pivnakeduardovich/SPEKS.SLS/README.md

<div align="center">

# СПЕКС

### Компактный SLS-принтер с альтернативной системой подачи порошка

</div>

---

## О проекте

**СПЕКС** — это доступный принтер селективного лазерного спекания (SLS) для мелкосерийного производства и изготовления оснастки. Главная идея проекта в **удешевлённой подаче порошка**: вместо дорогого второго поршня или барабана порошок засыпается в бункер сверху и разравнивается гребёнкой на каретке.

## Ключевые характеристики

| Параметр | Значение |
|---|---|
| Область печати | 150 × 150 × 150 мм |
| Кинематика XY | H-bot на валах Ø10 мм, подшипники LM10UU с уплотнителями |
| Ось Z | подъёмный столик, без ходовых винтов в зоне печати |
| Лазер | CO₂-трубка сбоку, луч идёт через систему зеркал |
| Подача порошка | бункер сверху + гребёнка на каретке, съёмная коробка объёмом ×1,5 от зоны печати |
| Камера | герметичная, с подогревом, моторы вынесены за изоляцию |
| Корпус | обшивка из стеклотекстолита, теплоизоляция |
| Моторы | NEMA 17 (X, Y, гребёнка, подача), NEMA 23 (Z, высота гребёнки) |
| Электроника | BTT Octopus Pro + Klipper |

## Как это работает

```
   ┌──────────── бункер с порошком ────────────┐
   │                    ▼                      │
   │   гребёнка на каретке разравнивает слой   │
   │                    ▼                      │
   │   CO₂-лазер → зеркала → спекание слоя     │
   │                    ▼                      │
   │   стол опускается на толщину слоя (Z)     │
   └──────────────── повтор ───────────────────┘
```

## Структура репозитория

| Папка | Что внутри |
|---|---|
| [`A3D/`](A3D) | сборки КОМПАС-3D. Актуальная сборка принтера: «Арт СБОРКА (пересборка)». Узлы: «Бункер подачи» (короб с поршнем, винтом и мотором), «Каркас» и «Профиль стола 2» (рама из профиля 20×20). Прежние версии: «Внутренняя коробка», «Коробка 2.0» |
| [`M3D/`](M3D) | детали. Листовые из алюминия 3 мм: «Бункер настольный 2.0» и детали бункера подачи (плита опорная, короб, крышка, поршень, кронштейн мотора, уголок). Остальное: рама стола, каретки, направляющие, винты, лазерная трубка |
| [`STEP/`](STEP) | STEP-модели покупных и собственных деталей (профиль 20×20, подшипники, моторы, зеркала) |
| [`SLS stp for IA/`](SLS%20stp%20for%20IA) | исходная рабочая сборка. В [`АртSLS/`](SLS%20stp%20for%20IA/АртSLS) лежат детали и подсборки актуальной версии: портал XY, гребёнка, ремни, оптика, моторы |
| [`kicad/`](kicad) | электрическая схема в KiCad (проект `speks.kicad_pro`, 3 листа) и её PDF |
| [`Мои профили/`](Мои%20профили) | библиотека профилей КОМПАС |

> Файлы `.a3d` и `.m3d` открываются в **КОМПАС-3D**, `.stp` / `.STEP` — в любом CAD (Fusion 360, FreeCAD, SolidWorks).

## Дорожная карта

- [x] Выбор кинематики (H-bot) и схемы подачи порошка
- [x] 3D-модель рамы, портала XY и оси Z
- [x] Компоновка лазера и зеркал
- [ ] Выбор модели CO₂-трубки
- [ ] Корпус и термоизоляция камеры
- [x] Принципиальная электрическая схема (KiCad)
- [ ] Электроника и конфиг Klipper
- [ ] Собственный слайсер
- [ ] Сборка прототипа и тестовая печать

---

<div align="center">
<sub>Автор: Piv · Научный руководитель: Алёна Павловна</sub>
</div>
