pivnakeduardovich/SPEKS.SLS/docs/images/obshiy_vid.png

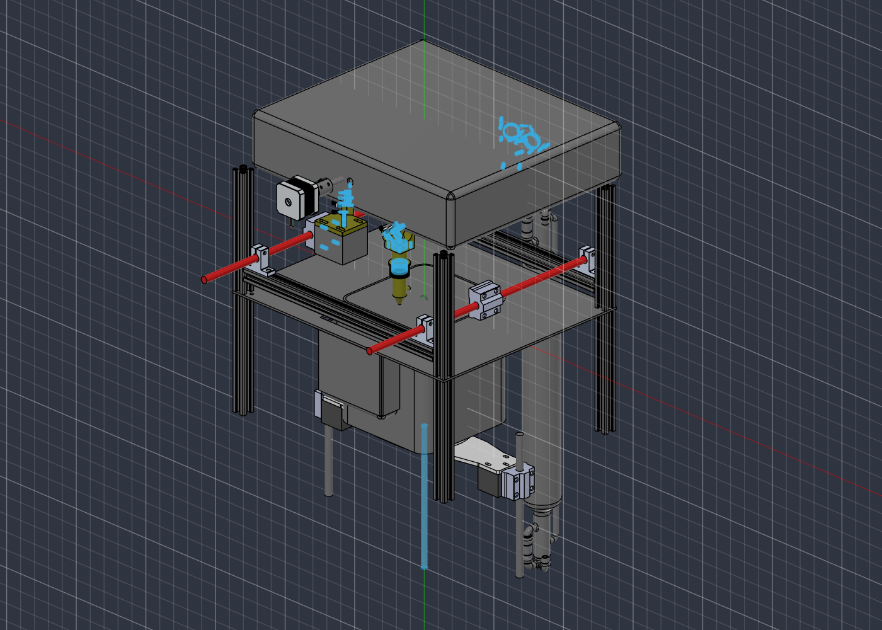
docs/images/obshiy_vid.png
