pivnakeduardovich/SPEKS.SLS/docs/images/vid_speredi.png

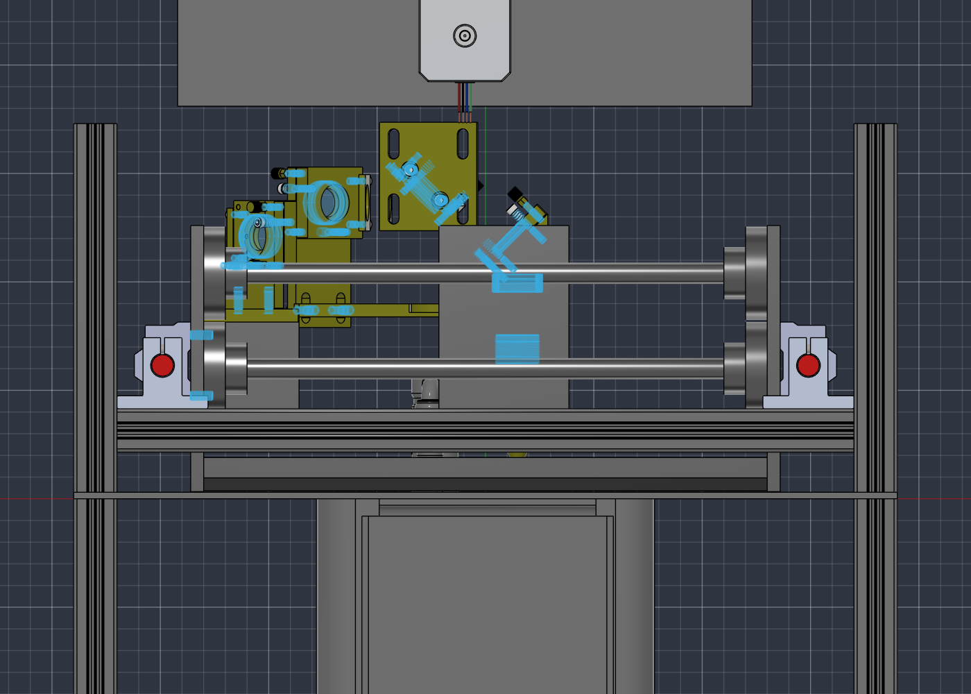
docs/images/vid_speredi.png
