pivnakeduardovich/SPEKS.SLS/docs/images/xy_portal.png

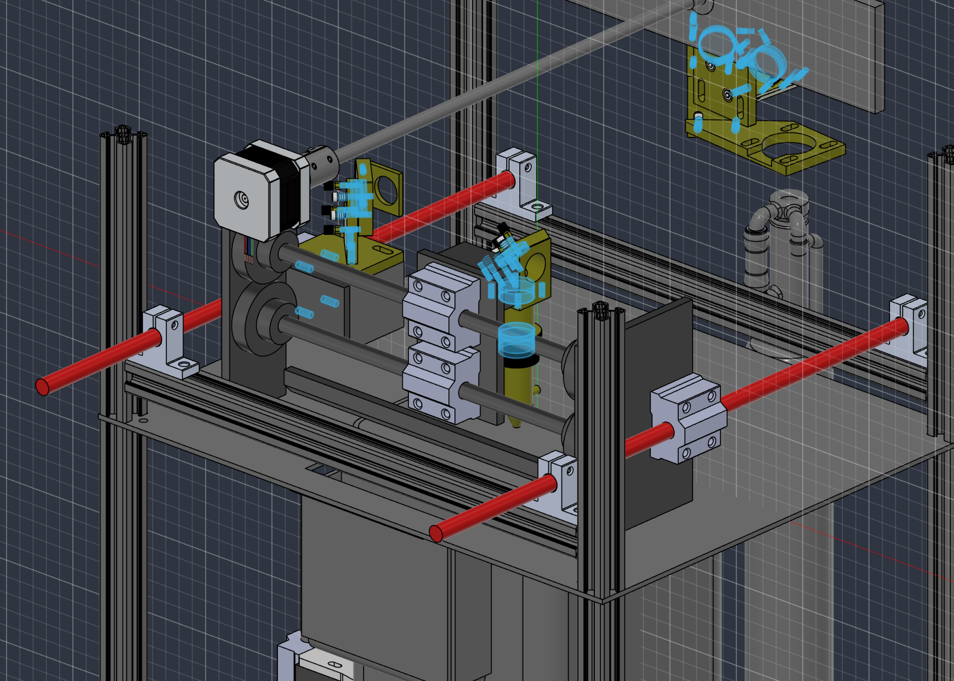
docs/images/xy_portal.png
