pivnakeduardovich/SPEKS.SLS/SLS stp for IA/АртSLS/CoreXY.png

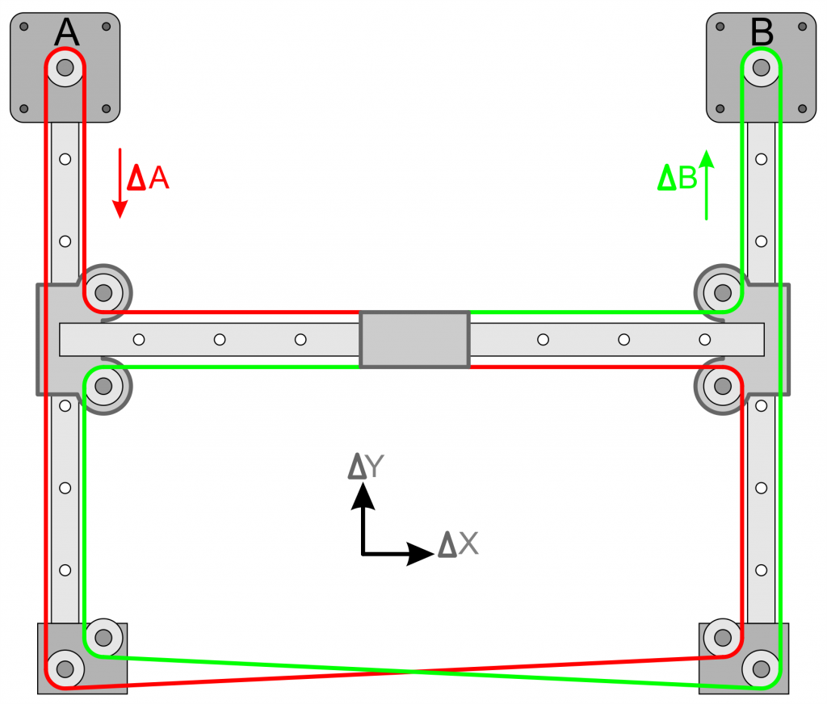
SLS stp for IA/АртSLS/CoreXY.png
