pivnakeduardovich/SPEKS.SLS/SLS stp for IA/АртSLS/H-bot.png

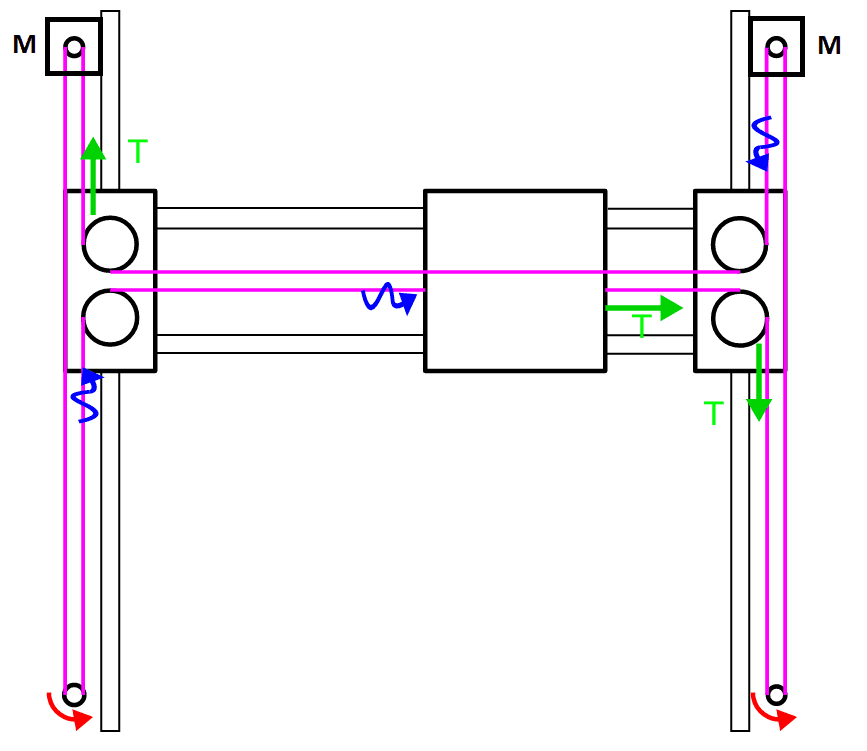
SLS stp for IA/АртSLS/H-bot.png
