pivnakeduardovich/SPEKS.SLS/docs/elektrika/spetsifikatsiya.csv

Группа | Поз. обозначение | Наименование | Тип / модель | Кол. | Цена за ед., руб. | Сумма, руб. | Примечание
Управление | A1 | Плата управления | BTT Octopus Pro V1.1 (STM32F446) | 1 | 6500 | 6500
Управление | — | Драйвер шагового двигателя | BTT TMC2209 V1.3 | 4 | 350 | 1400 | для M1, M2, M5, M6
Управление | — | Драйвер шагового двигателя | BTT TMC5160 Pro, SPI, до 3 А | 2 | 1300 | 2600 | допущение: для M3, M4 | TMC2209 не тянет 2,8 А
Управление | A2 | Одноплатный компьютер, хост Klipper | Orange Pi Zero 3, 1 ГБ | 1 | 2200 | 2200 | допущение: подойдёт любой Raspberry Pi
Управление | — | Карта памяти | microSD 16 ГБ, класс 10 | 1 | 400 | 400
Управление | — | Кабель USB | USB-A — USB-C, 0,5 м | 1 | 150 | 150 | A1 ↔ A2
Управление | A3 | Плата сопряжения лазера (самодельная) | макетная плата 5×7 см | 1 | 100 | 100
Управление | DA1, DA2 | Оптрон | PC817 | 2 | 20 | 40 | на A3
Управление | R1, R2 | Резистор | 330 Ом, 0,25 Вт | 2 | 5 | 10 | на A3
Управление | R3 | Резистор | 4,7 кОм, 0,25 Вт | 1 | 5 | 5 | на A3, подтяжка IN
Питание и защита | XP1 | Сетевой шнур с вилкой | 3×0,75 мм², вилка с PE, разъём C13 | 1 | 250 | 250
Питание и защита | XS1, SA1 | Сетевой разъём с выключателем и держателем предохранителя | IEC C14 + выключатель KCD, 3 в 1 | 1 | 250 | 250
Питание и защита | FU1 | Предохранитель | 5×20 мм, 5 А, 250 В | 2 | 20 | 40 | 1 запасной
Питание и защита | SB1 | Кнопка аварийного останова | «грибок», НЗ, 10 А 250 В, серия LAY37 / XB2 | 1 | 300 | 300
Питание и защита | G1 | Блок питания 24 В | Mean Well LRS-200-24 (24 В, 8,8 А) | 1 | 2400 | 2400 | допущение: нагрузка ≈ 110 Вт
Питание и защита | U1 | Понижающий преобразователь 24 → 5 В | XL4015, 5 А | 1 | 200 | 200 | питание A2
Питание и защита | — | Клеммники на DIN-рейку и DIN-рейка | для шин L, N, PE | 1 компл. | 400 | 400
Лазер и охлаждение | V1 | Лазерная CO₂-трубка | 40 Вт, Ø50 × 700 мм (класс K40) | 1 | 9000 | 9000 | допущение: модель не выбрана
Лазер и охлаждение | G2 | Блок питания лазера | MYJG-40, вход 220 В | 1 | 5000 | 5000 | допущение
Лазер и охлаждение | PA1 | Миллиамперметр | щитовой 0–30 мА (85C1) | 1 | 400 | 400 | в цепи катода
Лазер и охлаждение | — | Высоковольтный провод | силиконовый, 30–40 кВ | 1 м | 300 | 300 | G2 → анод V1
Лазер и охлаждение | SP1 | Реле протока воды | лопастное, замыкается при протоке | 1 | 600 | 600 | допущение
Лазер и охлаждение | M7 | Помпа охлаждения | погружная 220 В, 5–10 Вт, от 3 л/мин | 1 | 600 | 600 | допущение
Лазер и охлаждение | — | Бак, шланги ПВХ Ø8 мм, дистиллированная вода | 10 л | 1 компл. | 500 | 500
Лазер и охлаждение | SQ8 | Геркон крышки камеры с магнитом | MC-38, НО | 1 | 150 | 150
Нагрев камеры | VS1–VS3 | Твердотельное реле | Fotek SSR-25DA (вход 3–32 В DC) | 3 | 450 | 1350
Нагрев камеры | EK1 | Нагреватель стола | силиконовый, 150 × 150 мм, 220 В, 250 Вт | 1 | 1100 | 1100 | допущение
Нагрев камеры | EK2 | Нагреватель камеры | PTC алюминиевый, 220 В, 200 Вт | 1 | 600 | 600 | допущение
Нагрев камеры | SK1, SK2 | Термопредохранитель | KSD301, НЗ, порог под рабочую температуру + 20 °C | 2 | 100 | 200
Нагрев камеры | RK1–RK3 | Термистор | NTC 100 кОм B3950, стеклянный, до 300 °C | 3 | 120 | 360
Приводы и датчики | M1, M2, M5, M6 | Шаговый двигатель | NEMA17 17HS4401 (1,7 А, 40 мм) | 4 | 850 | 3400
Приводы и датчики | M3, M4 | Шаговый двигатель | NEMA23 JK57HM76-2804 (2,8 А) | 2 | 2200 | 4400
Приводы и датчики | SQ1–SQ7 | Концевой выключатель | микропереключатель KW12-3 с рычагом | 7 | 60 | 420
Приводы и датчики | M8 | Вентилятор | 24 В, 80 × 80 мм | 1 | 200 | 200 | обдув A1
Провода и монтаж | — | Провод сигнальный, моторы и датчики | 4 × 0,35 мм² (24 AWG) | 15 м | 40 | 600
Провода и монтаж | — | Провод термостойкий в зоне камеры | МГТФ 0,35 мм² (ПТФЭ) | 5 м | 80 | 400 | к RK1, RK2, SQ в камере
Провода и монтаж | — | Провод сетевой | ПВС 3 × 0,75 мм² | 5 м | 60 | 300
Провода и монтаж | — | Провод питания 24 В | 1,5 мм² (16 AWG), красный и чёрный | 2 м | 75 | 150
Провода и монтаж | — | Разъёмы JST-XH, наконечники НШВИ, термоусадка | набор | 1 | 700 | 700
 |  |  |  |  | Итого | 47975
