pivnakeduardovich/SPEKS.SLS/STEP/B432-Vtulka-sharikovaya-dlya-valov-_-10-mm.STEP

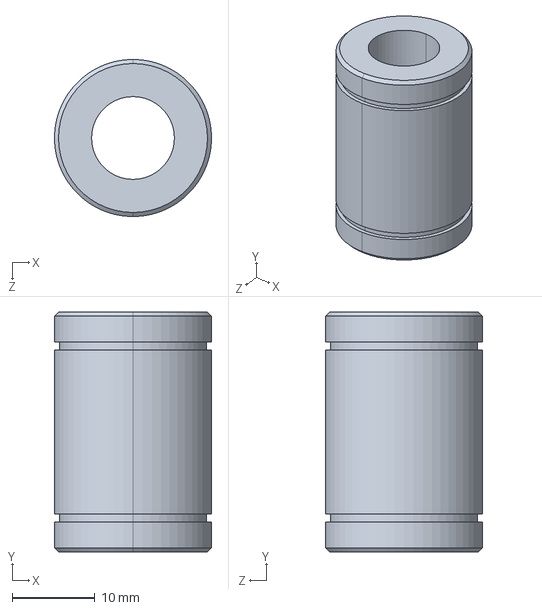
[picture p6: CAD file, 2026-11-05]
STEP/B432-Vtulka-sharikovaya-dlya-valov-_-10-mm.STEP
19.0 x 29.0 x 19.0 mm
