pivnakeduardovich/SPEKS.SLS/STEP/Внутренняя коробка .stp

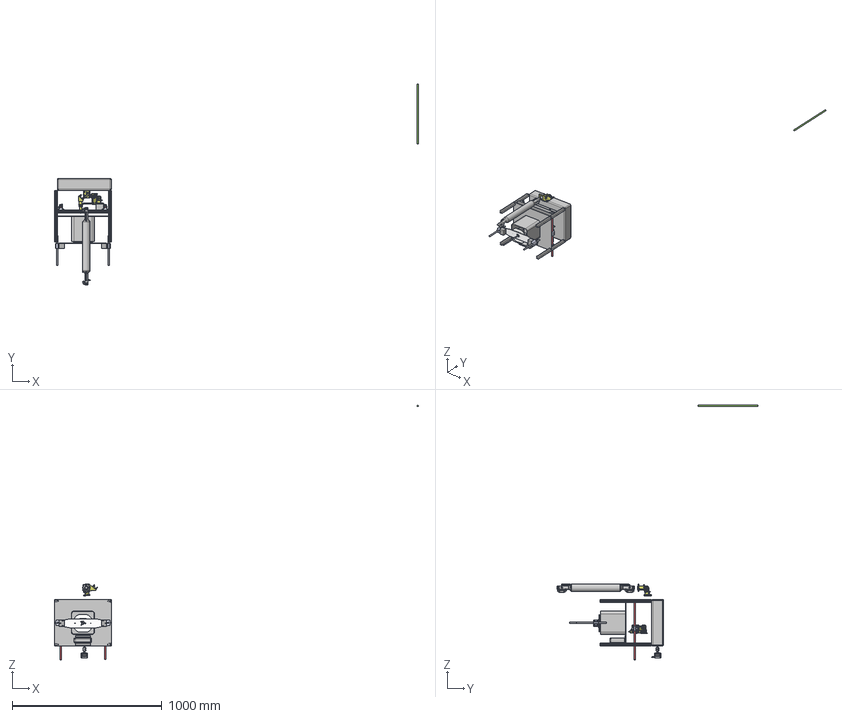
[picture p7: CAD file, 2026-11-05]
STEP/Внутренняя коробка .stp
2433.0 x 1342.6 x 1703.0 mm
NAUO2 x 4
NAUO3 x 6
X x 2
Y
NAUO1 x 3
NAUO1-01 x 3
Nema 17 Stepper Motor length 34mm
RingSpacer:1
BottomMovingPlate:1
