pivnakeduardovich/SPEKS.SLS/STEP/Коробка 2.0.stp

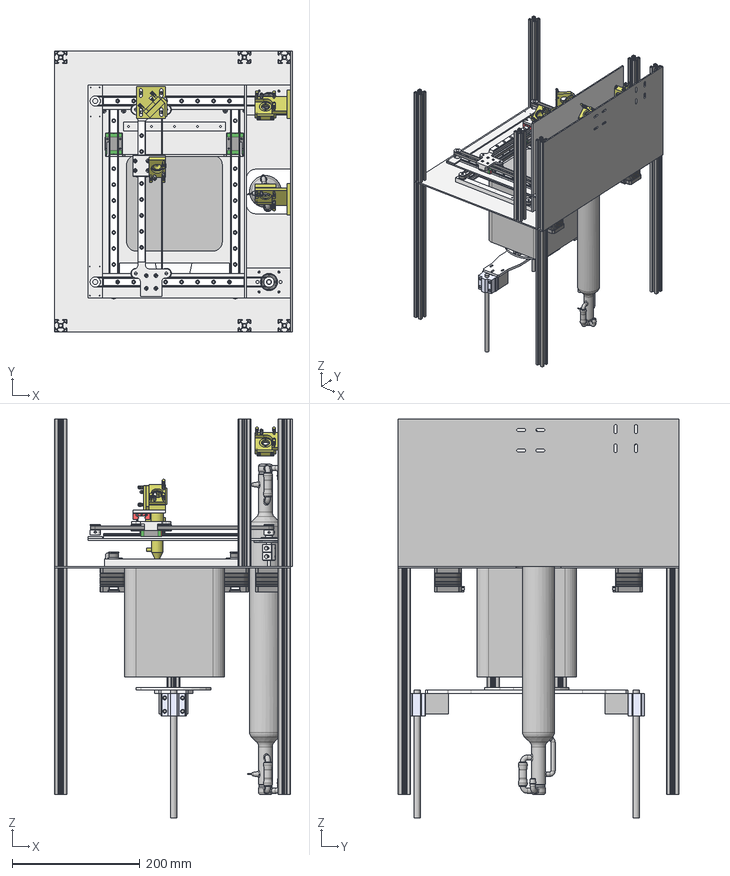
[picture p8: CAD file, 2026-11-05]
STEP/Коробка 2.0.stp
373.0 x 440.0 x 624.5 mm
NAUO1-01
RingSpacer:1
BottomMovingPlate:1
NAUO1
