pivnakeduardovich/SPEKS.SLS/STEP/B452-Flantsevyy-opornyy-podshipnik-KFL00-dlya-valov-_-10-mm.STEP

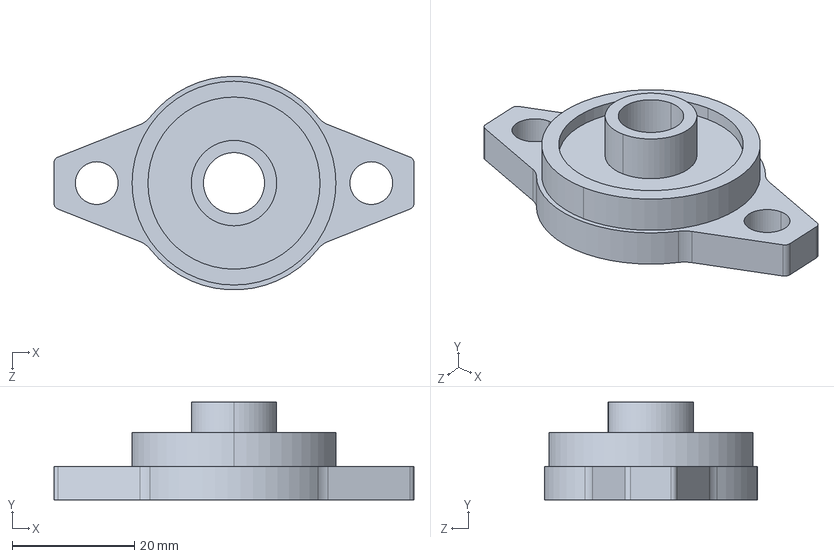
[picture p9: CAD file, 2026-11-05]
STEP/B452-Flantsevyy-opornyy-podshipnik-KFL00-dlya-valov-_-10-mm.STEP
59.0 x 16.0 x 35.0 mm
