pivnakeduardovich/SPEKS.SLS/STEP/B428-Derzhatel-polirovannykh-valov-SK12.STEP

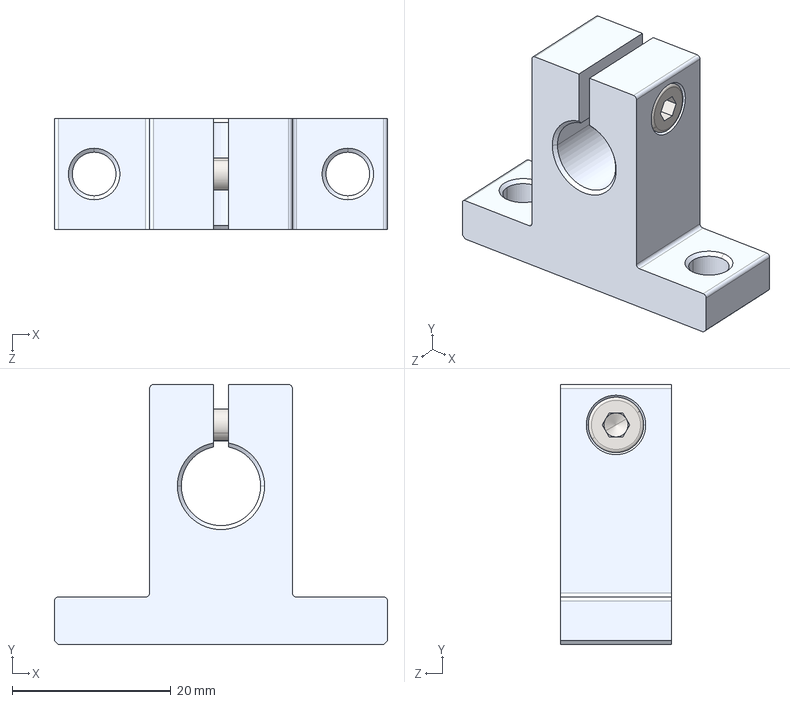
[picture p10: CAD file, 2026-11-05]
STEP/B428-Derzhatel-polirovannykh-valov-SK12.STEP
42.0 x 32.8 x 14.0 mm
B428 Держатель полированных валов SK12_00
socket head cap screw_din_DIN 912 M4 x 12 --- 12N
