pivnakeduardovich/SPEKS.SLS/STEP/Z19-Uplotnitel-pazovyy_-paz-6.STEP

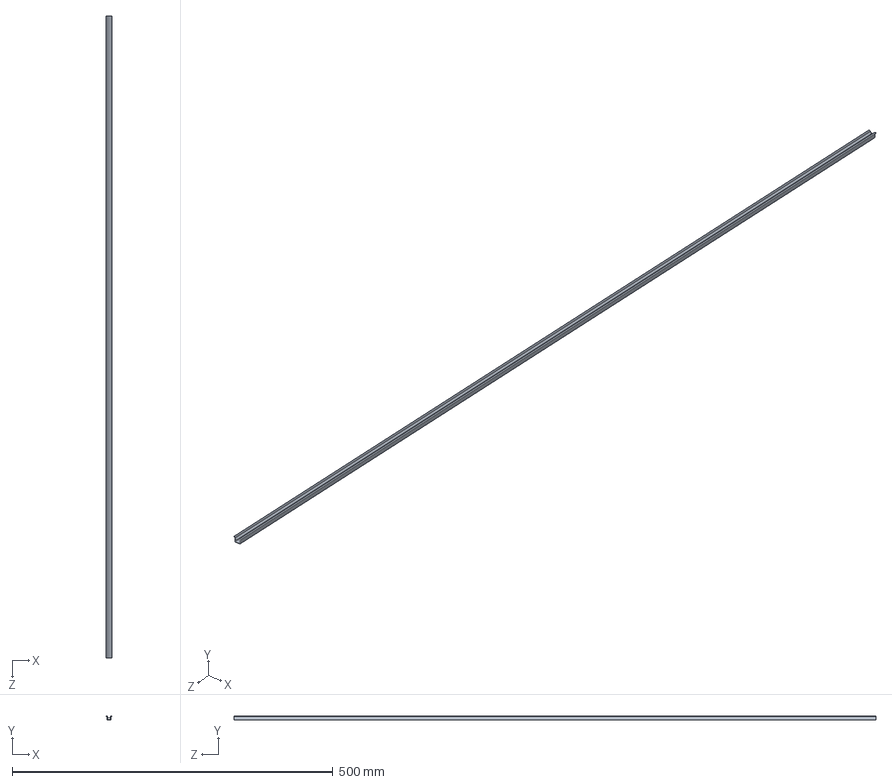
[picture p11: CAD file, 2026-11-05]
STEP/Z19-Uplotnitel-pazovyy_-paz-6.STEP
8.90 x 6.10 x 1000.0 mm
