pivnakeduardovich/SPEKS.SLS/STEP/A782-Kreplenie-dlya-stola_-30-seriya.STEP

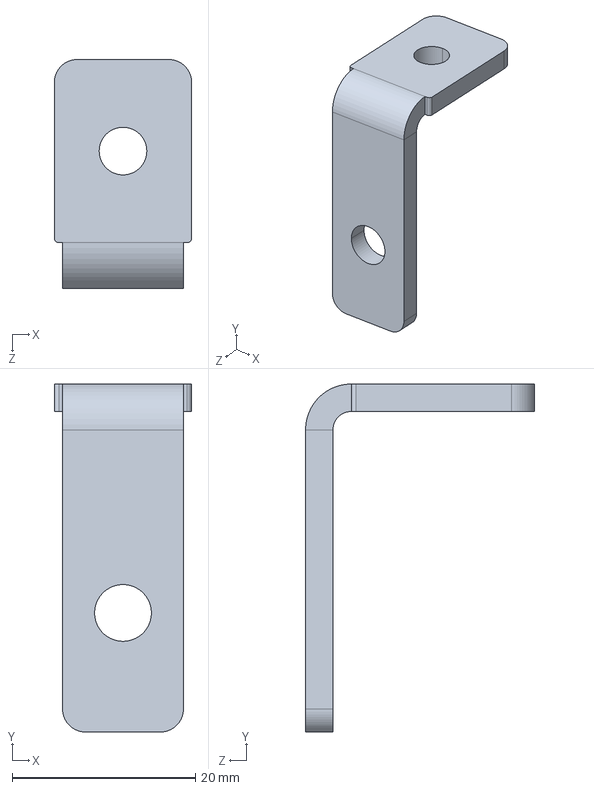
[picture p12: CAD file, 2026-11-05]
STEP/A782-Kreplenie-dlya-stola_-30-seriya.STEP
15.0 x 38.0 x 25.0 mm
