pivnakeduardovich/SPEKS.SLS/STEP/_Зеркало2.stp

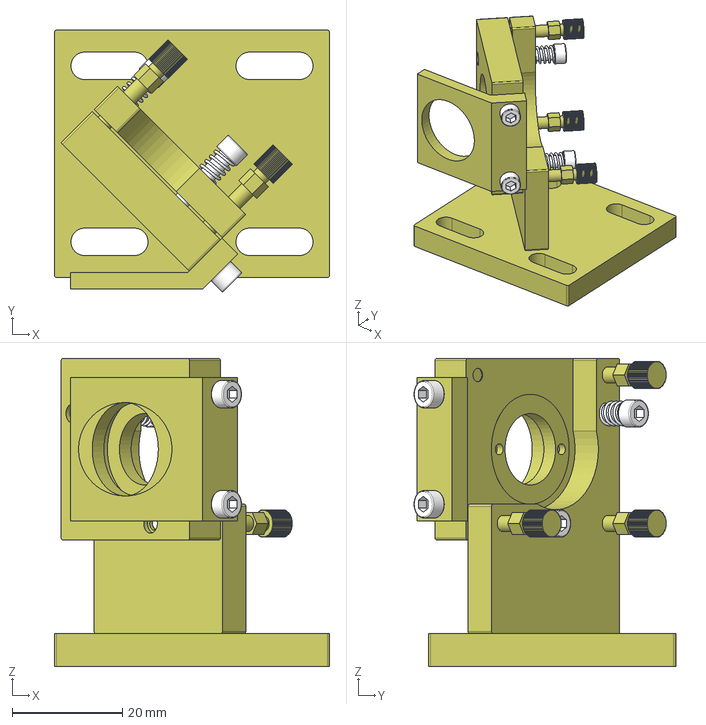
[picture p13: CAD file, 2026-11-05]
STEP/_Зеркало2.stp
50.0 x 47.6 x 56.0 mm
