pivnakeduardovich/SPEKS.SLS/STEP/Nema 17-34.stp

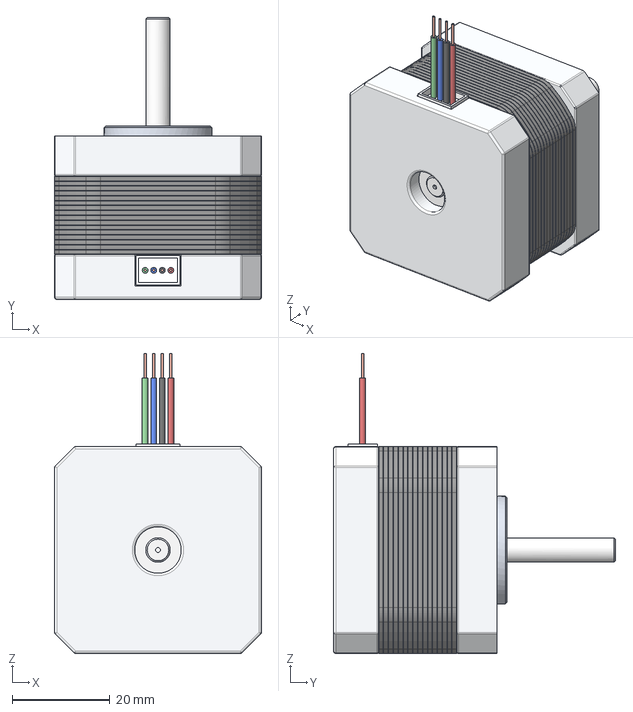
[picture p14: CAD file, 2026-11-05]
STEP/Nema 17-34.stp
42.3 x 57.6 x 61.3 mm
