pivnakeduardovich/SPEKS.SLS/STEP/A189-SHkiv-GT2_-_-otverstiya-8-mm.STEP

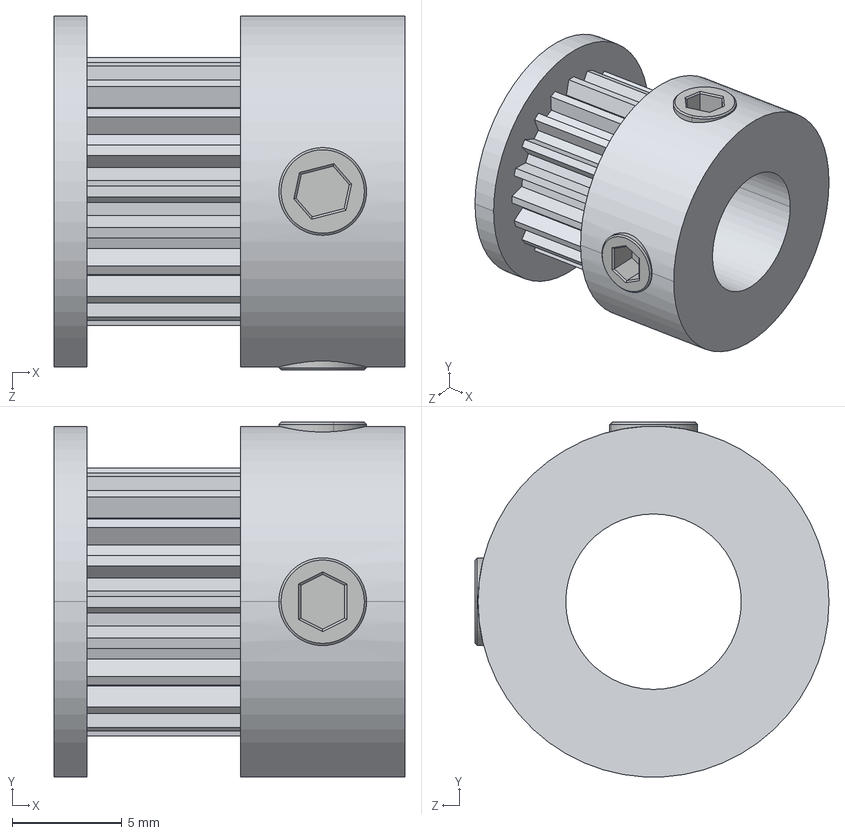
[picture p15: CAD file, 2026-11-05]
STEP/A189-SHkiv-GT2_-_-otverstiya-8-mm.STEP
16.0 x 16.2 x 16.1 mm
A189 Øêèâ GT2, O îòâåðñòèÿ 8 ìì(ïîäðîáíàÿ ìîäåëü)
S54 妈眚 篑蜞眍忸黜 DIN 916 _M4(4) x 2
