pivnakeduardovich/SPEKS.SLS/STEP/Зеркала.stp

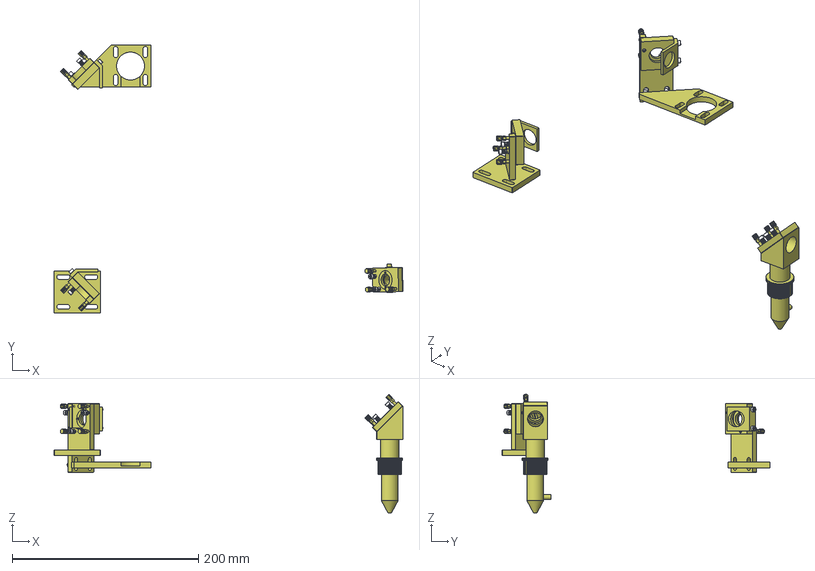
[picture p16: CAD file, 2026-11-05]
STEP/Зеркала.stp
375.2 x 287.9 x 127.5 mm
