pivnakeduardovich/SPEKS.SLS/STEP/B443-Lineynyy-podshipnik-SCS-v-alyuminievom-korpuse-dlya-valov-_-10-mm.STEP

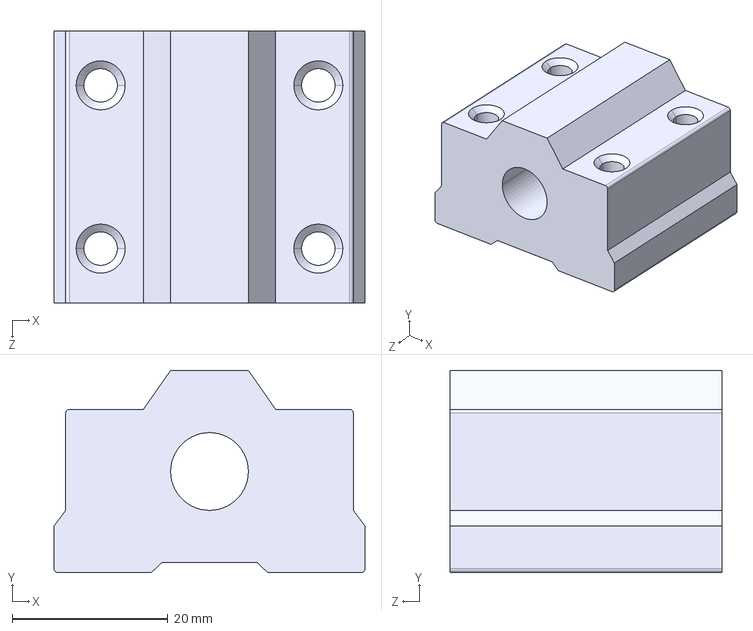
[picture p17: CAD file, 2026-11-05]
STEP/B443-Lineynyy-podshipnik-SCS-v-alyuminievom-korpuse-dlya-valov-_-10-mm.STEP
40.0 x 26.0 x 35.0 mm
