pivnakeduardovich/SPEKS.SLS/STEP/_Зеркало1.stp

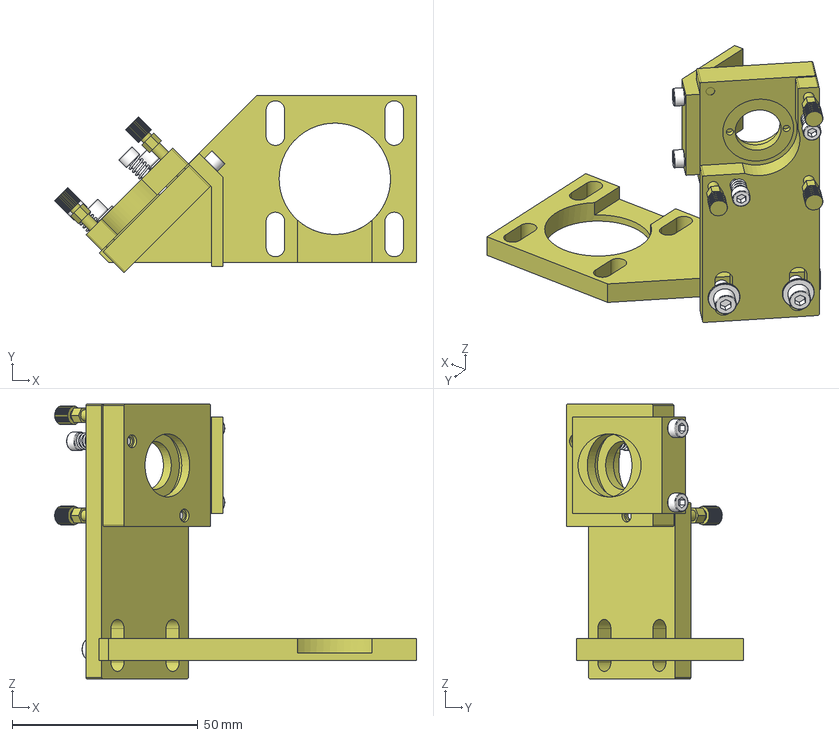
[picture p18: CAD file, 2026-11-05]
STEP/_Зеркало1.stp
97.5 x 47.8 x 74.0 mm
