pivnakeduardovich/SPEKS.SLS/STEP/A372-Vnutrenniy-uglovoy-soedinitel_-paz-6.STEP

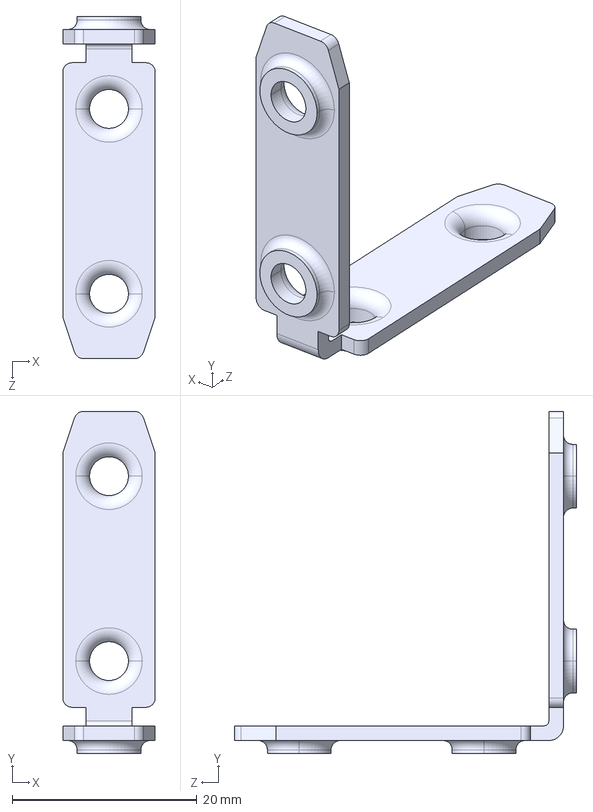
[picture p19: CAD file, 2026-11-05]
STEP/A372-Vnutrenniy-uglovoy-soedinitel_-paz-6.STEP
10.0 x 37.0 x 37.0 mm
