pivnakeduardovich/SPEKS.SLS/STEP/222LX-Konstruktsionnyy-profil-20kh20L.STEP

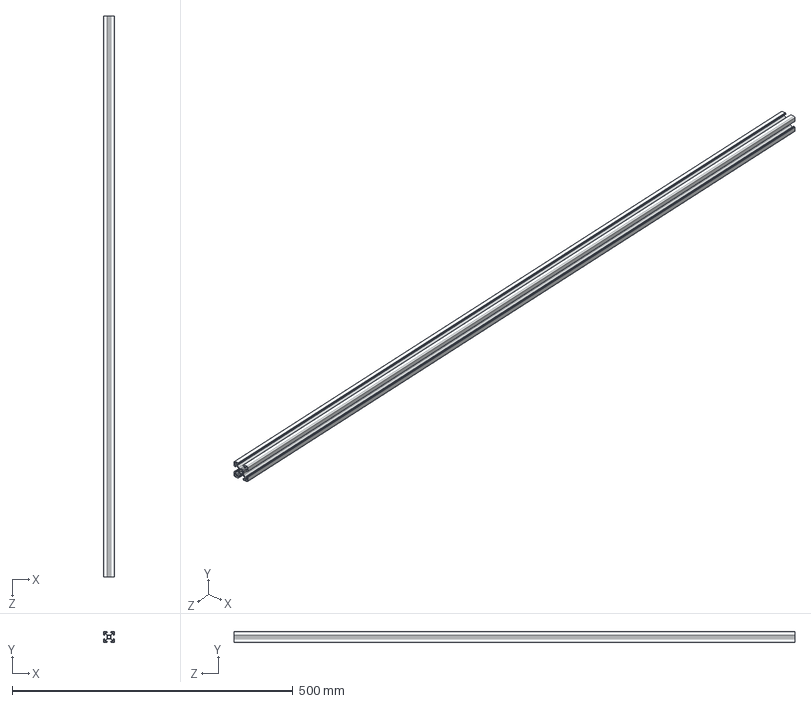
[picture p20: CAD file, 2026-11-05]
STEP/222LX-Konstruktsionnyy-profil-20kh20L.STEP
20.0 x 20.0 x 1000.0 mm
