pivnakeduardovich/SPEKS.SLS/STEP/B516-SHagovyy-dvigatel-Nema-23.STEP

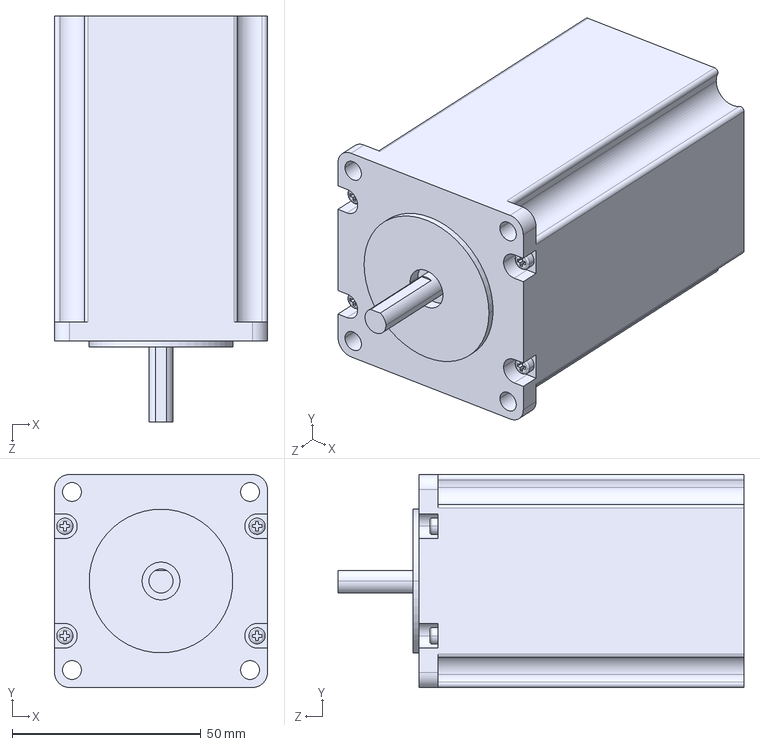
[picture p21: CAD file, 2026-11-05]
STEP/B516-SHagovyy-dvigatel-Nema-23.STEP
56.4 x 56.4 x 107.5 mm
