pivnakeduardovich/SPEKS.SLS/STEP/_Зеркало3.stp

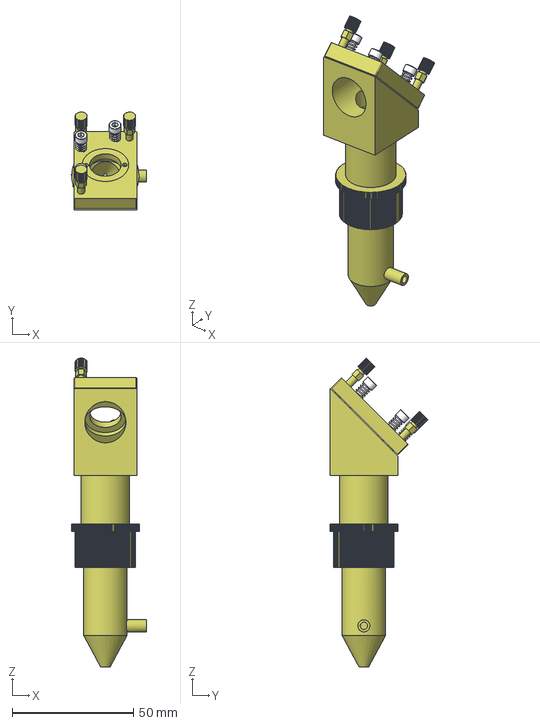
[picture p22: CAD file, 2026-11-05]
STEP/_Зеркало3.stp
31.0 x 40.5 x 127.5 mm
