pivnakeduardovich/SPEKS.SLS/STEP/M51-Ugolok-20kh20L.STEP

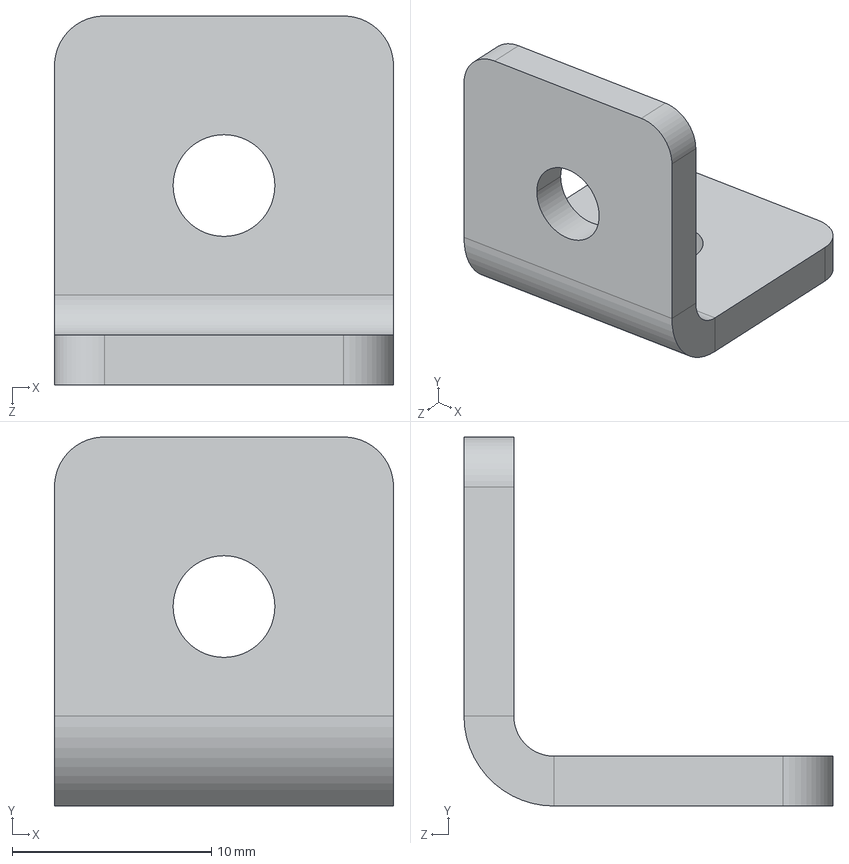
[picture p23: CAD file, 2026-11-05]
STEP/M51-Ugolok-20kh20L.STEP
17.0 x 18.5 x 18.5 mm
