pivnakeduardovich/SPEKS.SLS/STEP/4ad8d019baf454c6bbd45c2c6ffb6783.STEP

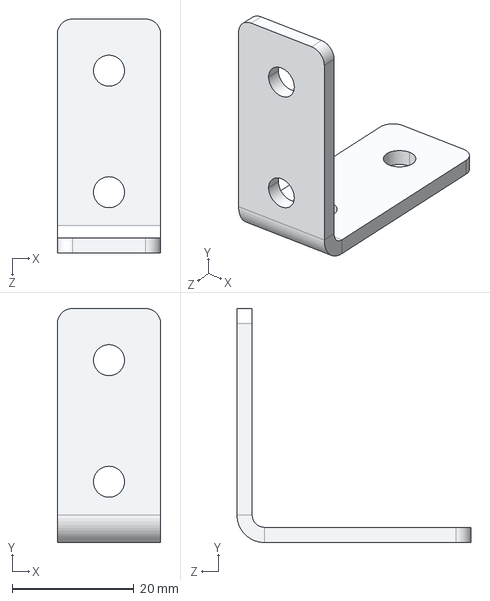
[picture p24: CAD file, 2026-11-05]
STEP/4ad8d019baf454c6bbd45c2c6ffb6783.STEP
17.0 x 38.5 x 38.5 mm
