pivnakeduardovich/SPEKS.SLS/STEP/H34-Sukhar-pazovyy-M5_-paz-6.STEP

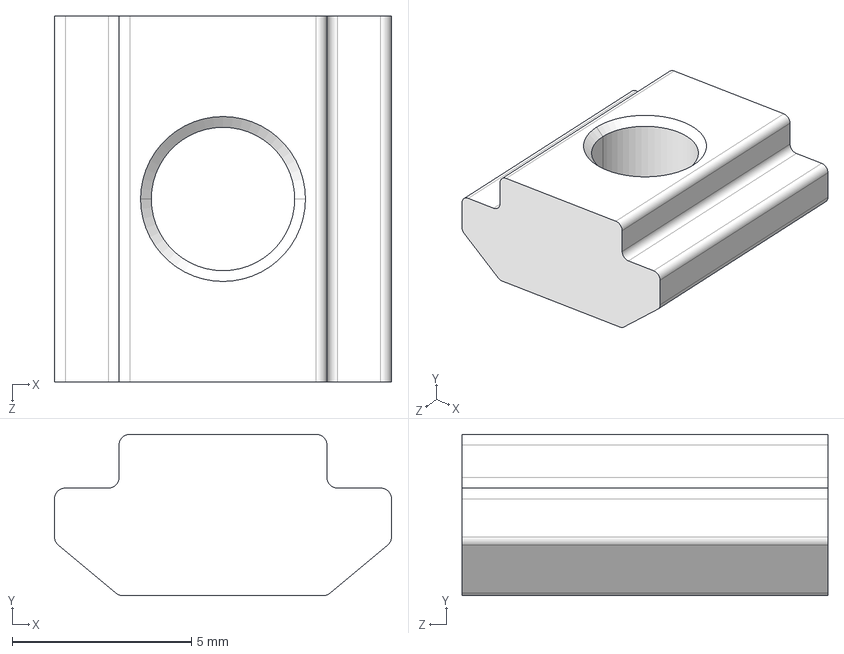
[picture p25: CAD file, 2026-11-05]
STEP/H34-Sukhar-pazovyy-M5_-paz-6.STEP
9.40 x 4.50 x 10.2 mm
