pivnakeduardovich/SPEKS.SLS/STEP/A216-Trapetseidalnyy-vint-8kh290-mm_-4_kh-zakhodnyy_-shag-2-mm.STEP

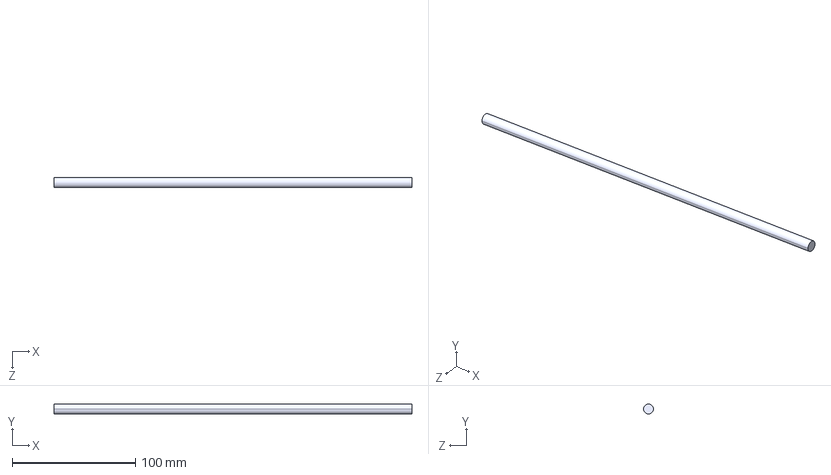
[picture p26: CAD file, 2026-11-05]
STEP/A216-Trapetseidalnyy-vint-8kh290-mm_-4_kh-zakhodnyy_-shag-2-mm.STEP
290.0 x 8.00 x 8.00 mm
