pivnakeduardovich/SPEKS.SLS/STEP/GX2025-5-8.STEP

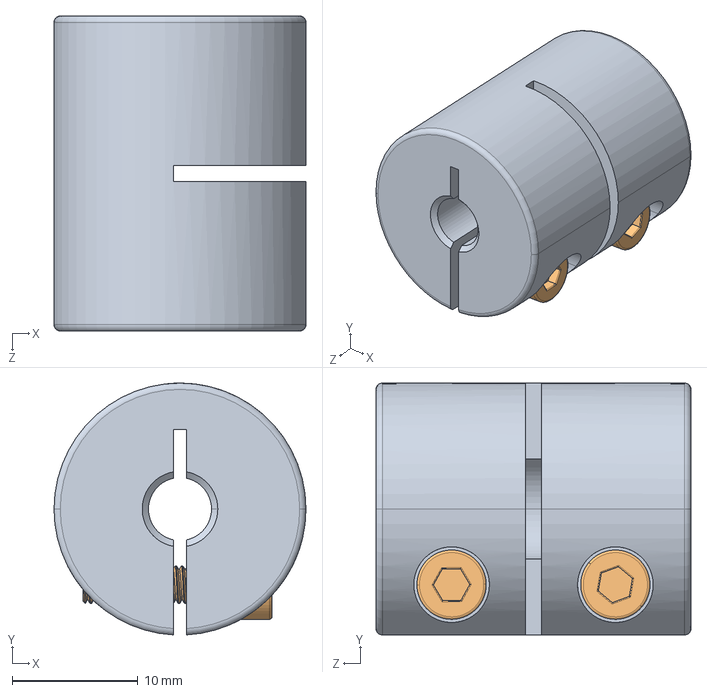
[picture p27: CAD file, 2026-11-05]
STEP/GX2025-5-8.STEP
20.0 x 20.0 x 25.0 mm
GX2025-5-8
M3-12 x 2
