pivnakeduardovich/SPEKS.SLS/(list of files, cad)

Other CAD files:
eBom-prt30.stp.SLDPRT
