pivnakeduardovich/SPEKS.SLS/kicad/silovaya_i_lazer.kicad_sch

## KiCad design kicad/silovaya_i_lazer.kicad_sch (2026-11-13)

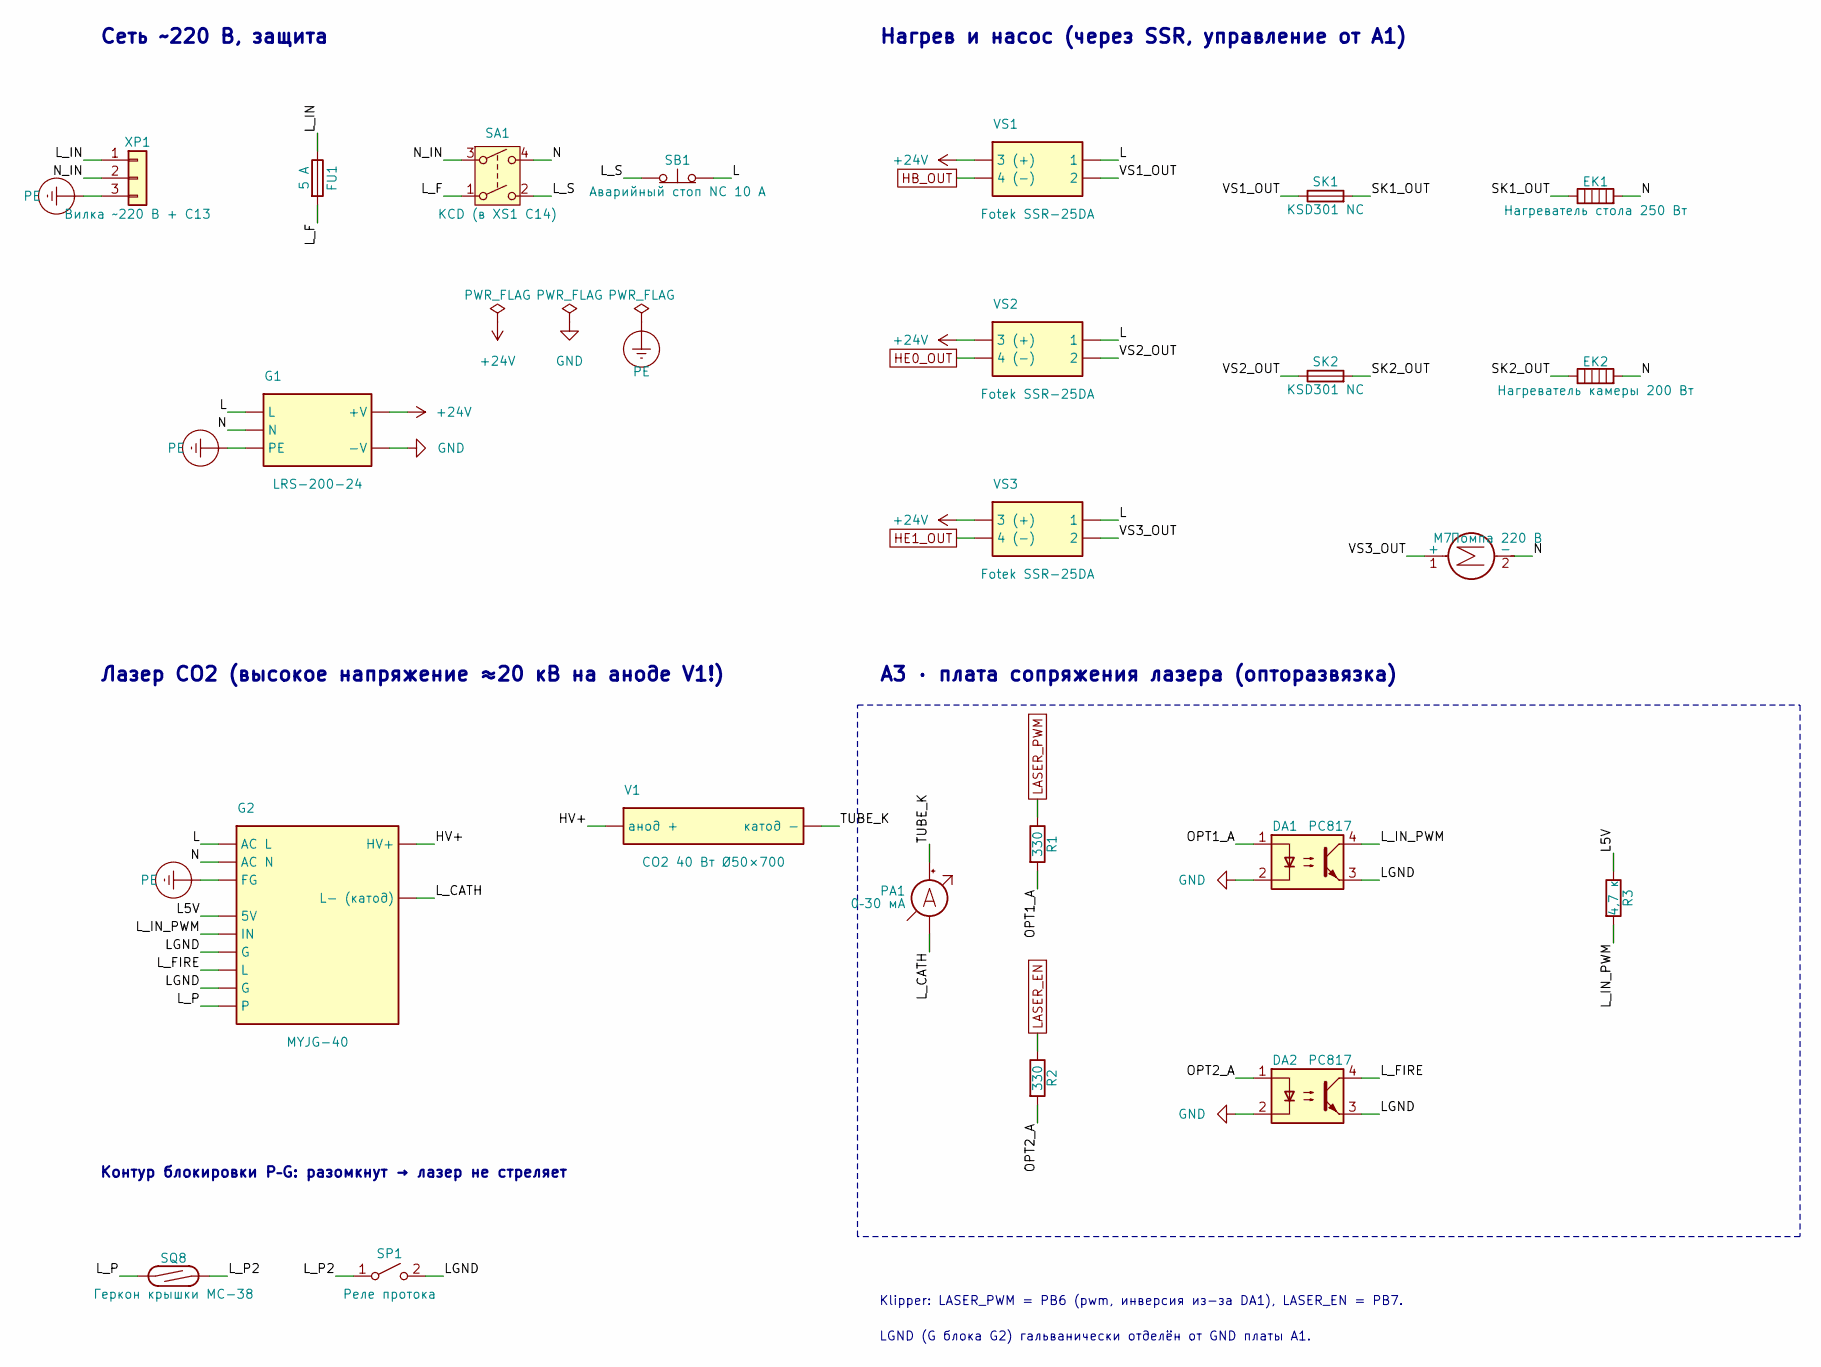
[picture p28: schematic silovaya_i_lazer.kicad_sch]

Parts:
DA1, DA2: PC817
EK1: Нагреватель стола 250 Вт
EK2: Нагреватель камеры 200 Вт
FU1: 5 А
G1: LRS-200-24
G2: MYJG-40
M7: Помпа 220 В
PA1: 0–30 мА
R1, R2: 330
R3: 4,7 к
SA1: KCD (в XS1 C14)
SB1: Аварийный стоп NC 10 А
SK1, SK2: KSD301 NC
SP1: Реле протока
SQ8: Геркон крышки MC-38
V1: CO2 40 Вт Ø50×700
VS1, VS2, VS3: Fotek SSR-25DA
XP1: Вилка ~220 В + C13

Connections:
+24V: G1.V+ (+V), VS1.3 (3 (+)), VS2.3 (3 (+)), VS3.3 (3 (+))
GND: DA1.2, DA2.2, G1.V- (-V)
HB_OUT: VS1.4 (4 (-))
HE0_OUT: VS2.4 (4 (-))
HE1_OUT: VS3.4 (4 (-))
HV+: G2.HV (HV+), V1.A (анод +)
L: G1.L, G2.AC1 (AC L), SB1.2 (B), VS1.1, VS2.1, VS3.1
L5V: G2.5V, R3.1
LASER_EN: R2.1
LASER_PWM: R1.1
LGND: DA1.3, DA2.3, G2.G1 (G), G2.G2 (G), SP1.2 (B)
L_CATH: G2.LM (L- (катод)), PA1.1 (-)
L_F: FU1.2, SA1.1
L_FIRE: DA2.4, G2.L
L_IN: FU1.1, XP1.1
L_IN_PWM: DA1.4, G2.IN, R3.2
L_P: G2.P, SQ8.1
L_P2: SP1.1 (A), SQ8.2
L_S: SA1.2, SB1.1 (A)
N: EK1.2, EK2.2, G1.N, G2.AC2 (AC N), M7.2 (-), SA1.4
N_IN: SA1.3, XP1.2
OPT1_A: DA1.1, R1.2
OPT2_A: DA2.1, R2.2
PE: G1.PE, G2.FG, XP1.3
SK1_OUT: EK1.1, SK1.2
SK2_OUT: EK2.1, SK2.2
TUBE_K: PA1.2 (+), V1.K (катод -)
VS1_OUT: SK1.1, VS1.2
VS2_OUT: SK2.1, VS2.2
VS3_OUT: M7.1 (+), VS3.2

Notes on the sheet:
Сеть ~220 В, защита
Нагрев и насос (через SSR, управление от A1)
Лазер CO2 (высокое напряжение ≈20 кВ на аноде V1!)
Контур блокировки P–G: разомкнут → лазер не стреляет
A3 · плата сопряжения лазера (опторазвязка)
Klipper: LASER_PWM = PB6 (pwm, инверсия из-за DA1), LASER_EN = PB7.
LGND (G блока G2) гальванически отделён от GND платы A1.
