pivnakeduardovich/SPEKS.SLS/kicad/upravlenie.kicad_sch

## KiCad design kicad/upravlenie.kicad_sch (2026-11-13)

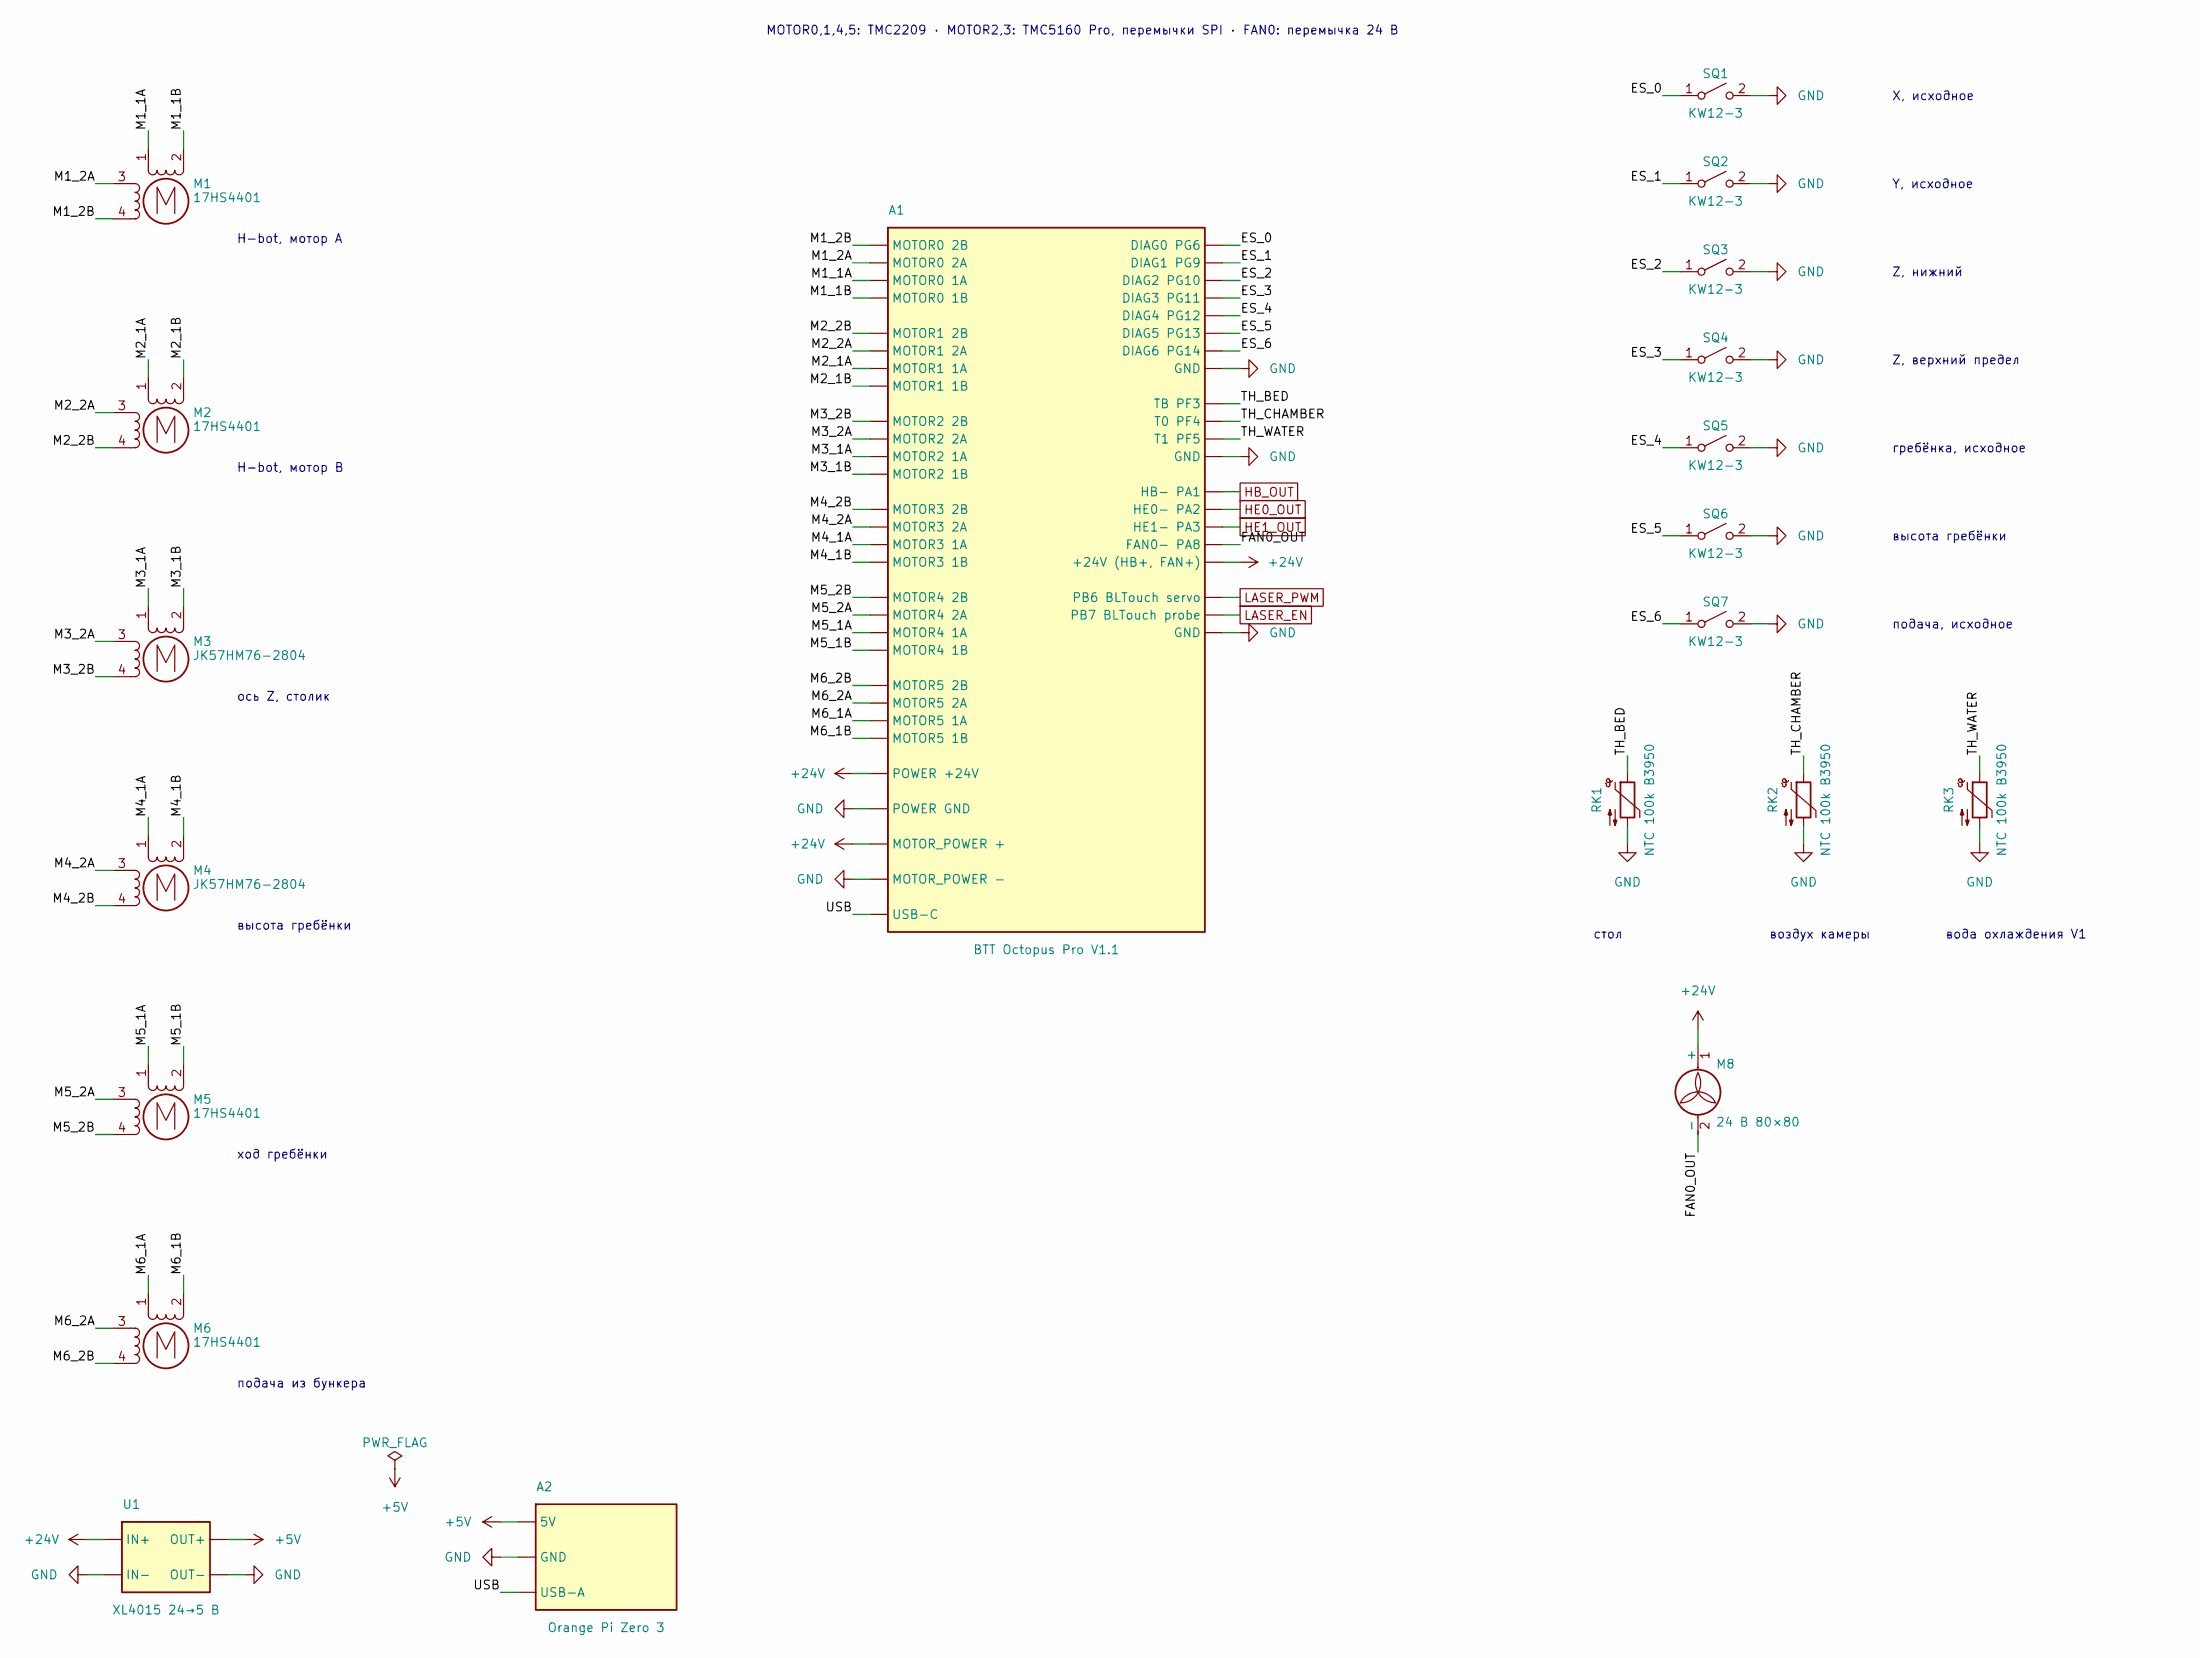
[picture p29: schematic upravlenie.kicad_sch]

Parts:
A1: BTT Octopus Pro V1.1
A2: Orange Pi Zero 3
M1, M2, M5, M6: 17HS4401
M3, M4: JK57HM76-2804
M8: 24 В 80×80
RK1, RK2, RK3: NTC 100k B3950
SQ1, SQ2, SQ3, SQ4, SQ5, SQ6, SQ7: KW12-3
U1: XL4015 24→5 В

Connections:
+5V: A2.5V, U1.OUT+
+24V: A1.MP+ (MOTOR_POWER +), A1.PWR+ (POWER +24V), A1.V24 (+24V (HB+, FAN+)), M8.1 (+), U1.IN+
ES_0: A1.DIAG0 (DIAG0 PG6), SQ1.1 (A)
ES_1: A1.DIAG1 (DIAG1 PG9), SQ2.1 (A)
ES_2: A1.DIAG2 (DIAG2 PG10), SQ3.1 (A)
ES_3: A1.DIAG3 (DIAG3 PG11), SQ4.1 (A)
ES_4: A1.DIAG4 (DIAG4 PG12), SQ5.1 (A)
ES_5: A1.DIAG5 (DIAG5 PG13), SQ6.1 (A)
ES_6: A1.DIAG6 (DIAG6 PG14), SQ7.1 (A)
FAN0_OUT: A1.FAN0 (FAN0- PA8), M8.2 (-)
GND: A1.GND1 (GND), A1.GND2 (GND), A1.GND3 (GND), A1.MP- (MOTOR_POWER -), A1.PWR- (POWER GND), A2.GND, RK1.2, RK2.2, RK3.2, SQ1.2 (B), SQ2.2 (B), SQ3.2 (B), SQ4.2 (B), SQ5.2 (B), SQ6.2 (B), SQ7.2 (B), U1.IN-, U1.OUT-
HB_OUT: A1.HB (HB- PA1)
HE0_OUT: A1.HE0 (HE0- PA2)
HE1_OUT: A1.HE1 (HE1- PA3)
LASER_EN: A1.PB7 (PB7 BLTouch probe)
LASER_PWM: A1.PB6 (PB6 BLTouch servo)
M1_1A: A1.M0_1A (MOTOR0 1A), M1.1
M1_1B: A1.M0_1B (MOTOR0 1B), M1.2 (-)
M1_2A: A1.M0_2A (MOTOR0 2A), M1.3
M1_2B: A1.M0_2B (MOTOR0 2B), M1.4
M2_1A: A1.M1_1A (MOTOR1 1A), M2.1
M2_1B: A1.M1_1B (MOTOR1 1B), M2.2 (-)
M2_2A: A1.M1_2A (MOTOR1 2A), M2.3
M2_2B: A1.M1_2B (MOTOR1 2B), M2.4
M3_1A: A1.M2_1A (MOTOR2 1A), M3.1
M3_1B: A1.M2_1B (MOTOR2 1B), M3.2 (-)
M3_2A: A1.M2_2A (MOTOR2 2A), M3.3
M3_2B: A1.M2_2B (MOTOR2 2B), M3.4
M4_1A: A1.M3_1A (MOTOR3 1A), M4.1
M4_1B: A1.M3_1B (MOTOR3 1B), M4.2 (-)
M4_2A: A1.M3_2A (MOTOR3 2A), M4.3
M4_2B: A1.M3_2B (MOTOR3 2B), M4.4
M5_1A: A1.M4_1A (MOTOR4 1A), M5.1
M5_1B: A1.M4_1B (MOTOR4 1B), M5.2 (-)
M5_2A: A1.M4_2A (MOTOR4 2A), M5.3
M5_2B: A1.M4_2B (MOTOR4 2B), M5.4
M6_1A: A1.M5_1A (MOTOR5 1A), M6.1
M6_1B: A1.M5_1B (MOTOR5 1B), M6.2 (-)
M6_2A: A1.M5_2A (MOTOR5 2A), M6.3
M6_2B: A1.M5_2B (MOTOR5 2B), M6.4
TH_BED: A1.TB (TB PF3), RK1.1
TH_CHAMBER: A1.T0 (T0 PF4), RK2.1
TH_WATER: A1.T1 (T1 PF5), RK3.1
USB: A1.USB (USB-C), A2.USB (USB-A)

Notes on the sheet:
MOTOR0,1,4,5: TMC2209 · MOTOR2,3: TMC5160 Pro, перемычки SPI · FAN0: перемычка 24 В
H-bot, мотор A
H-bot, мотор B
ось Z, столик
высота гребёнки
ход гребёнки
подача из бункера
X, исходное
Y, исходное
Z, нижний
Z, верхний предел
гребёнка, исходное
подача, исходное
стол
воздух камеры
вода охлаждения V1
