pivnakeduardovich/SPEKS.SLS/(commit log)

2026-11-05 Добавить файлы проекта из папки sls (КОМПАС-3D, STEP)
    Модели деталей и сборок SLS-принтера: A3D, M3D, STEP, «SLS stp for IA».
    Временные (~$*), резервные (*.bak) и лог-файлы исключены через .gitignore.
    Claude-Session: https://claude.ai/code/session_01DVMgzmFGFQPQ8fvF5fszMw
2026-11-05 Догрузить Nema 17-38.m3d
    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
2026-11-05 Оформить README: описание, характеристики, структура, рендеры
    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
2026-11-05 README: убрать картинки и значки
    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
2026-11-05 README: убрать бюджет
    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
2026-11-12 Электрика: принципиальная схема Э3 (2 листа) и спецификация
    Claude-Session: https://claude.ai/code/session_01DVMgzoLgjViVjPkwnqEnfQ
2026-11-12 Пересборка Арт СБОРКА, папка Claude в .gitignore
2026-11-12 Убрать электрику (docs/elektrika)
2026-11-12 Арт СБОРКА (пересборка): каркас и профиль стола в A3D, обновить положения
2026-11-13 Бункеры под новую модель: настольный 2.0 и поршневой бункер подачи, лист АМг3 3 мм
2026-11-13 README: обновить таблицу структуры репозитория
2026-11-13 Электросхема в KiCad: проект speks (корневой лист + силовая часть/лазер + управление), PDF
    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
